youyc22/Multifunctional/hardware/hardware/PCB/主板/实物图.png

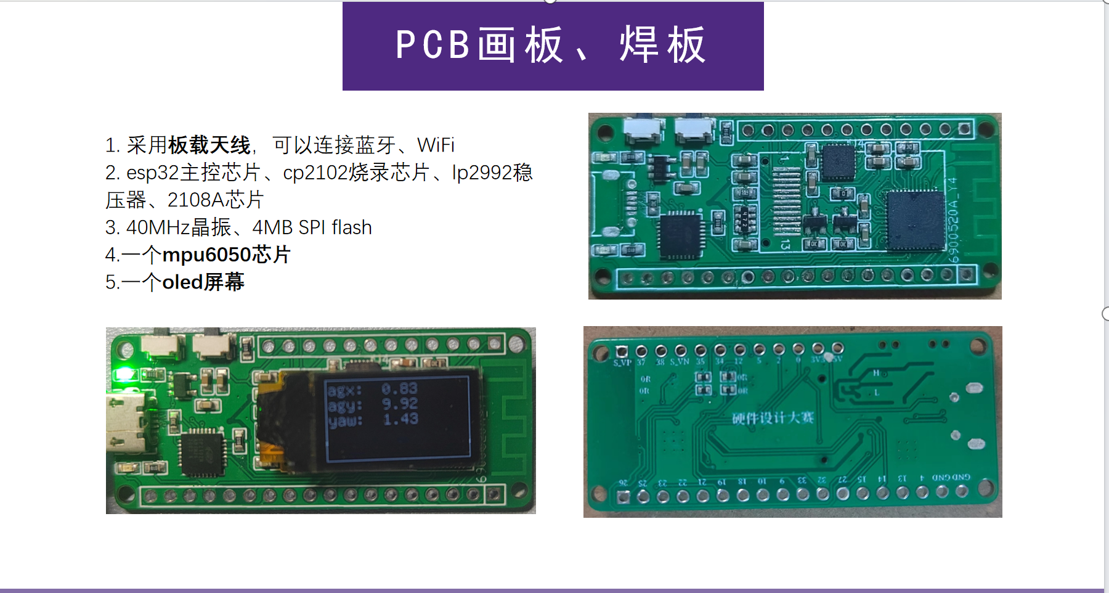
hardware/hardware/PCB/主板/实物图.png
