youyc22/Multifunctional/hardware/hardware/其他硬件材料/0a4875b89bd48880daa38f8a928440a.png

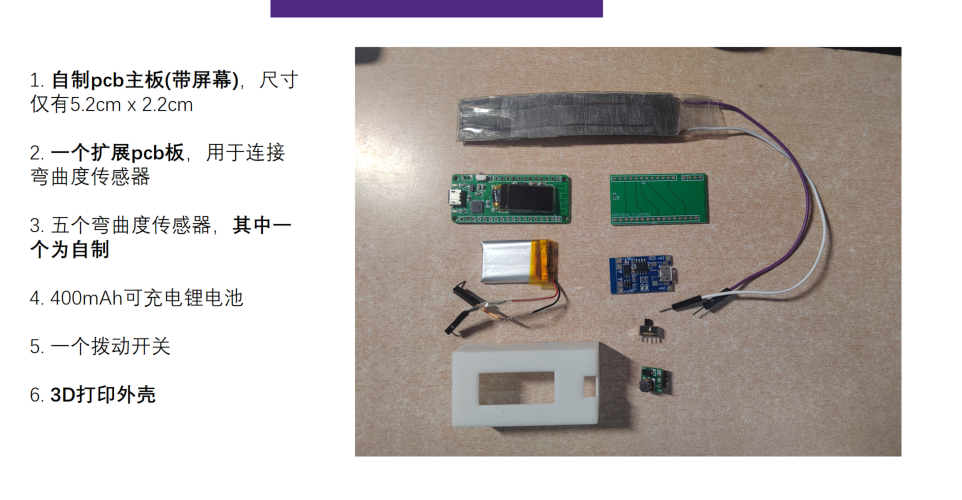
hardware/hardware/其他硬件材料/0a4875b89bd48880daa38f8a928440a.png
