youyc22/Multifunctional/hardware/Readme

1.PCB使用嘉立创eda
2.3D外壳可用solidworks打开
3.后续会较大改进PCB(画饼)
