youyc22/Multifunctional/software/Readme

1. Qt creator版本：5.11.3
2. unity3D：2022.3.3f1c1
3. arduino ide代码里的头文件都可在包管理器里下载
