youyc22/Multifunctional/完整报告.pdf

# 多功能蓝牙手套

无 23 尤忆晨 2022010576 无 21 李锦轩 2022010519

## 1.设计背景

我们组设计的作品名为多功能蓝牙手套，设计灵感来源于我们认为市面上的 PPT 翻页笔功能

太过单一，传统鼠标的使用太过局限，并且还存在一些不方便使用鼠标与键盘的场合，因此

我们组设计了一个数据手套来代替鼠标和键盘的功能。

## 2.功能简介

我们的多功能蓝牙手套主要有以下三个功能，首先是蓝牙键鼠，我们将手势分为默认手势以

及自定义手势，其中默认手势是我们已经设置好的，如食指弯曲相当于点击鼠标左键，中指

弯曲代表点击鼠标右键等等。第二个功能是手势自定义，我们用 Qt Creator 编写了一个上

位机能够让用户自定义手势（如图 1），手势可以是静态的，如比 OK 手势，也可以是动态的，

如打勾，用户在手势录制完成后可以在库中挑选对应的功能，如调整音量、局部截屏等等。

第三个功能是实时动捕，我们用 unity3D 搭建了一个手部模型（如图 2），能够捕捉到手部

的动作，并且搭建了简单的场景，能够完成拍球等简单交互。

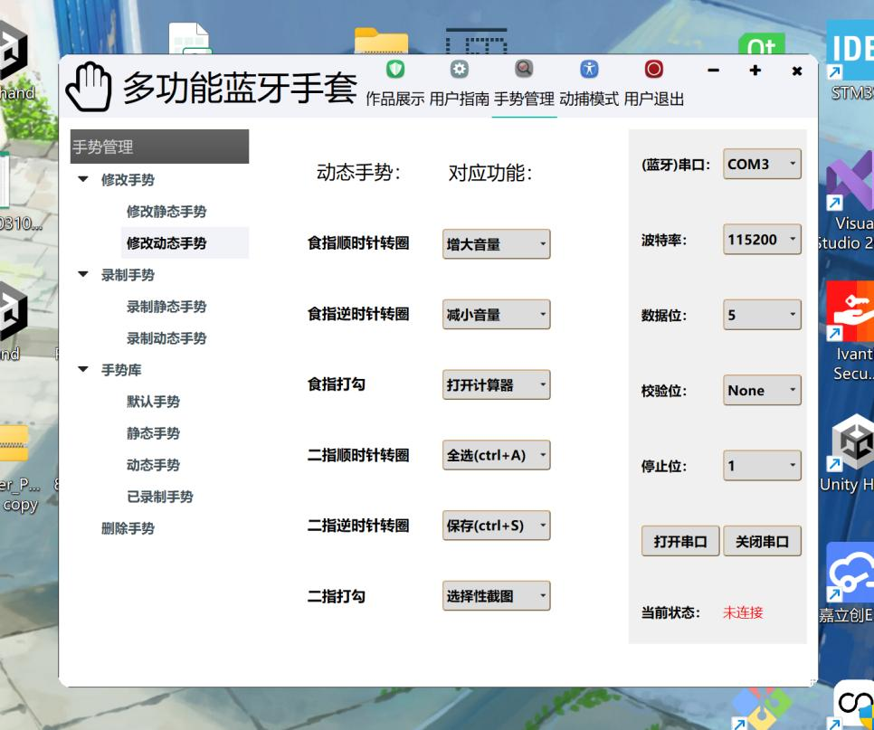
[picture p3: figure]

图 1

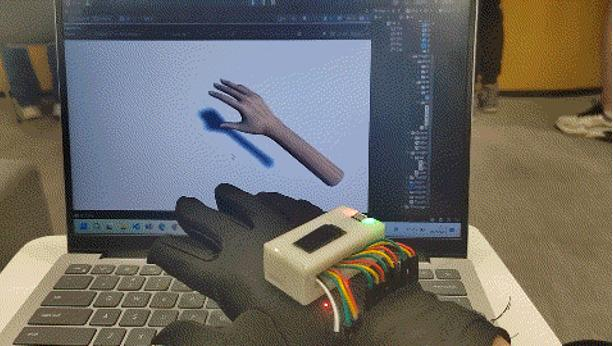
[picture p4: figure]

图 2

## 3.模块使用

为了使我们的手套更加轻便，我们使用了自制的 pcb 主板(带 oled 屏幕)，尺寸仅有 5.2cm x

2.2cm 和一个扩展 pcb 板，用于连接弯曲度传感器（如图 3-5）。在此期间我们一共打了三版

板子，但前两版均因集成度不够高被淘汰，最终第三版的体积能够满足我们的要求。我们的

pcb 板上搭载了一个 esp32 主控芯片、cp2102 烧录芯片、lp2992 稳压器、2108A 芯片和 40MHz

晶振、4MB SPI flash，以及一个 mpu6050 芯片和一个 oled 屏幕，并采用板载天线，可以连

接蓝牙、WiFi。我们在五根手指上装配了五个弯曲度传感器，其中一个为自制（如图 6）, 弯

曲度传感器实际上是一个高精度的薄片电阻，电阻弯曲后阻值发生变化。根据这个原理，我

们使用塑料片、白纸、铅笔芯、电线自制了一个简易的弯曲度传感器，基本可以满足手势识

别的需求。我们的手套还配有 400mAh 可充电锂电池，附带一个充电 usb 接口，充电完成后

可以大约续航三小时。此外手套上还装配了一个拨动开关和 3D 打印的外壳来放置板子。

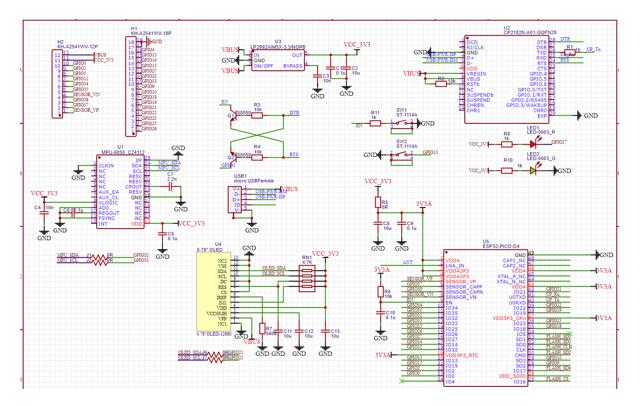
[picture p5: figure]

图 3

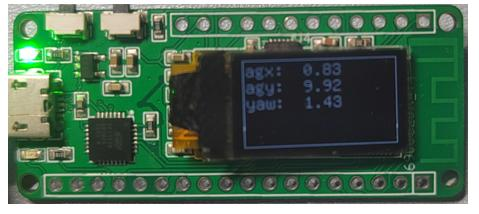
[picture p6: figure]

图 4

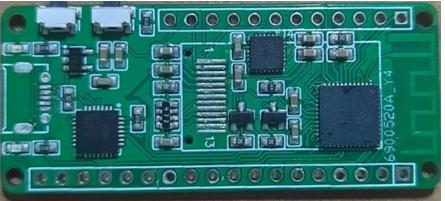
[picture p7: figure]

图 5

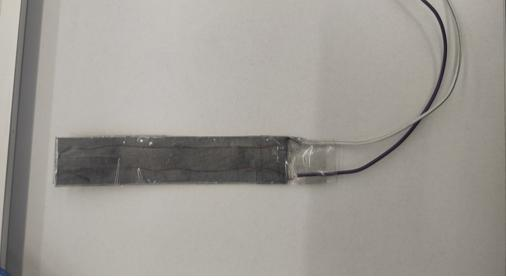
[picture p8: figure]

图 6

## 4.核心算法

（1）主程序框架

使用 3 层状态机

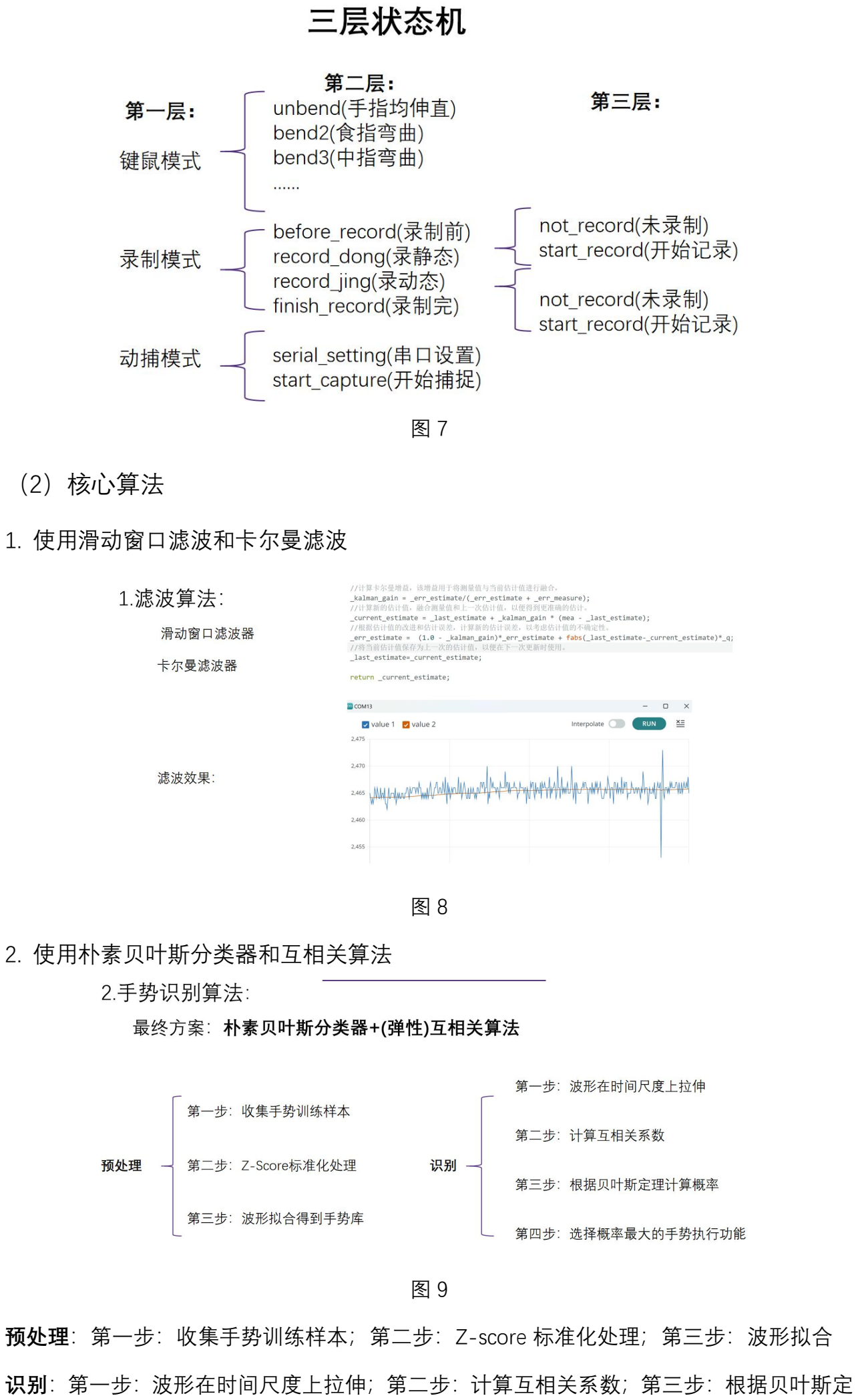
[picture p9: page 4]

图 7

## （2）核心算法

### 1. 使用滑动窗口滤波和卡尔曼滤波

图 8

### 2. 使用朴素贝叶斯分类器和互相关算法

图 9

### 预处理：第一步：收集手势训练样本；第二步：Z-score 标准化处理；第三步：波形拟合

### 识别：第一步：波形在时间尺度上拉伸；第二步：计算互相关系数；第三步：根据贝叶斯定

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

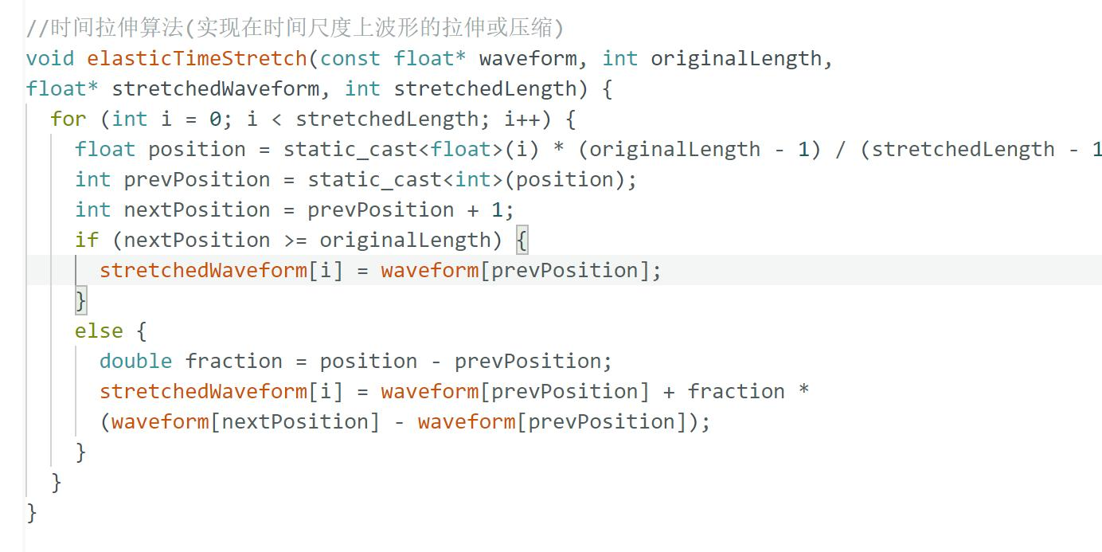
[picture p10: figure]
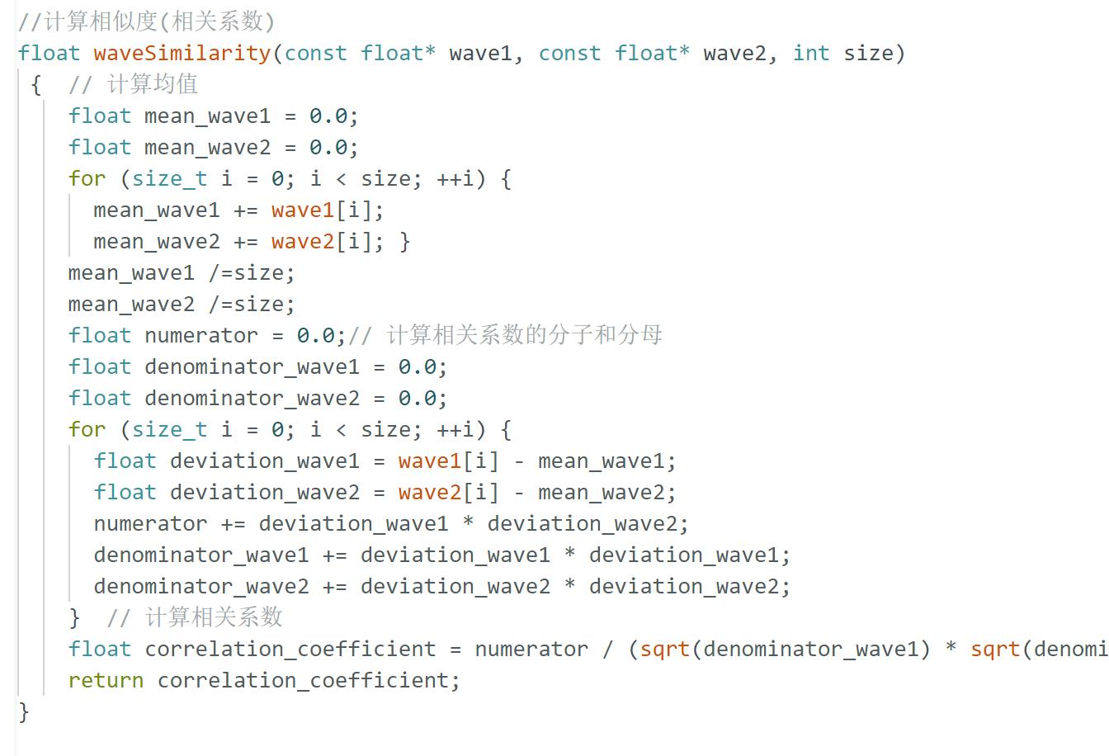
[picture p11: figure]

### 使用多线程执行程序，将蓝牙串口通信、oled 绘制等函数在新线程中执行，大大缩短

### 主程序执行时间，700 行主程序循环一次仅需 4 毫秒左右；

### 使用 SPIFFS 文件系统，实现上位机修改后的数据永久储存在开发板上，避免了反复烧

### 录的麻烦。

## 5.开发过程

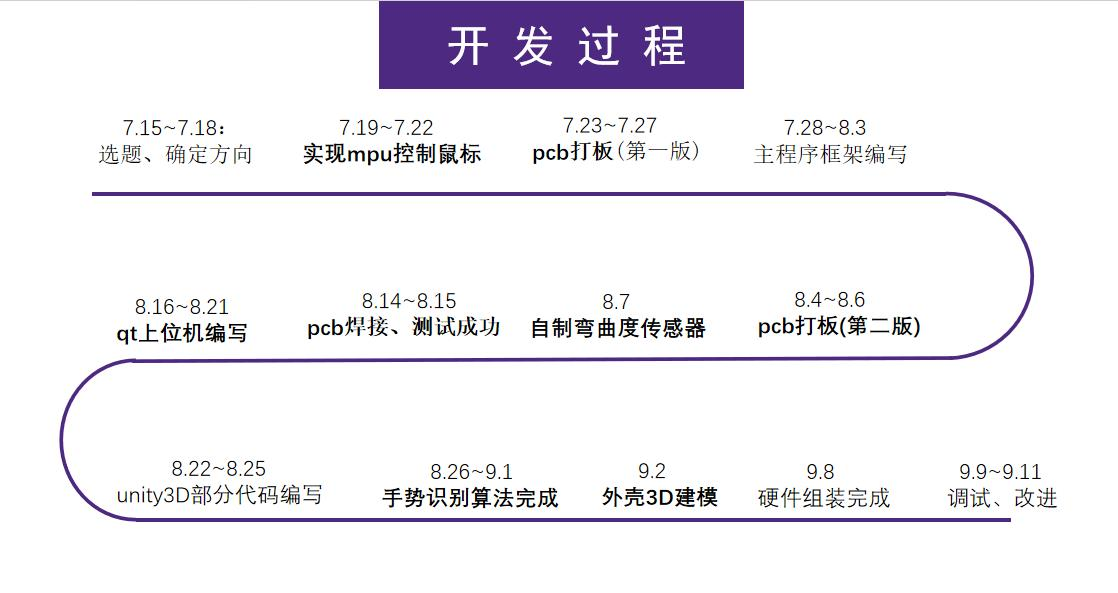
[picture p12: figure]

图 12
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
