youyc22/Multifunctional/hardware/hardware/PCB/扩展板/扩展版.jpg

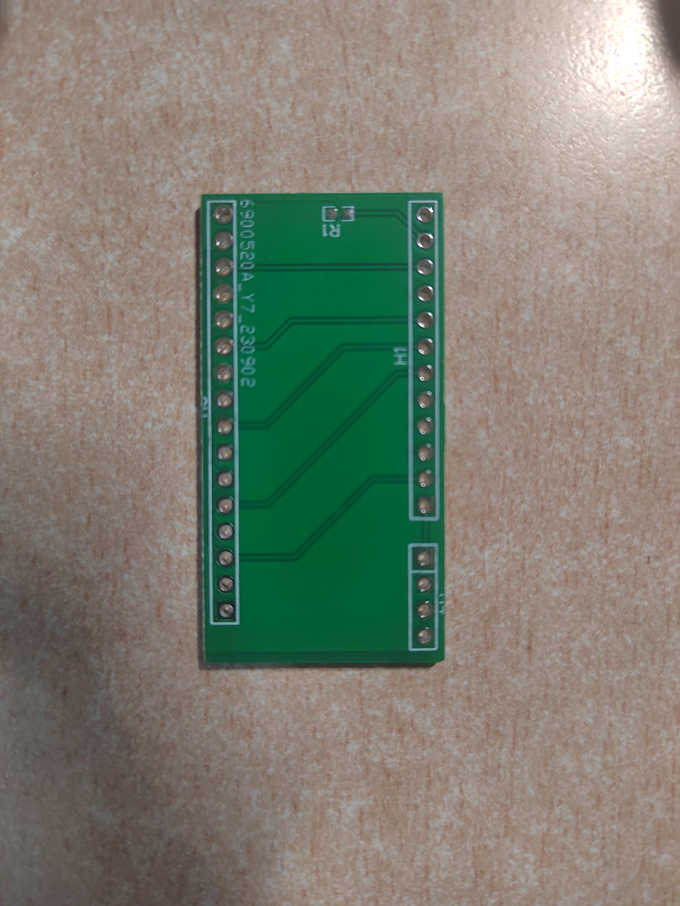
hardware/hardware/PCB/扩展板/扩展版.jpg
