youyc22/Multifunctional/hardware/hardware/PCB/扩展板/扩展版PCB.png

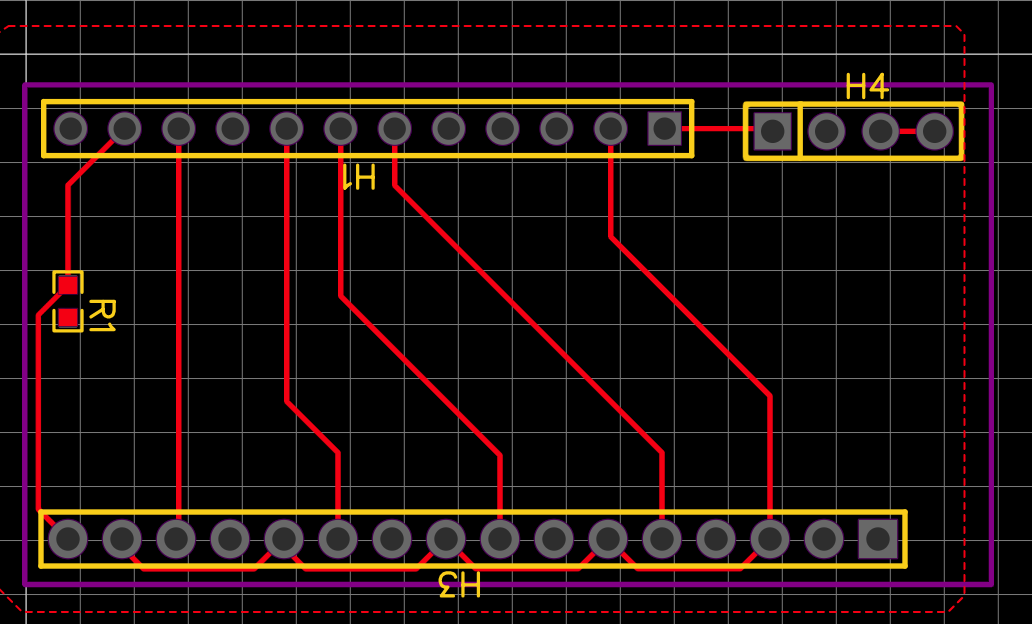
hardware/hardware/PCB/扩展板/扩展版PCB.png
