youyc22/Multifunctional/hardware/hardware/PCB/主板/PCB原理图.pdf

10 10 11 11 12 12 13 13 14 14 15 15 16 16 17 17 18 18

# GPIOs

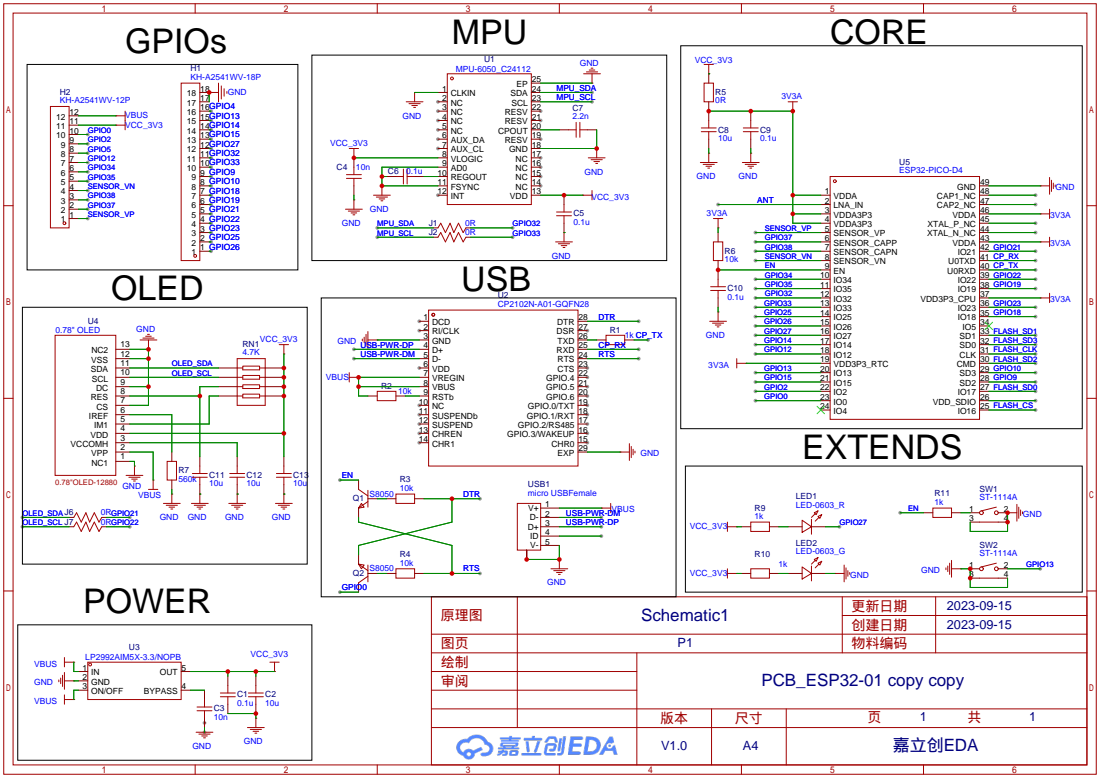
[picture p15: page 1]
