youyc22/Multifunctional/hardware/hardware/PCB/主板/PCB图.pdf

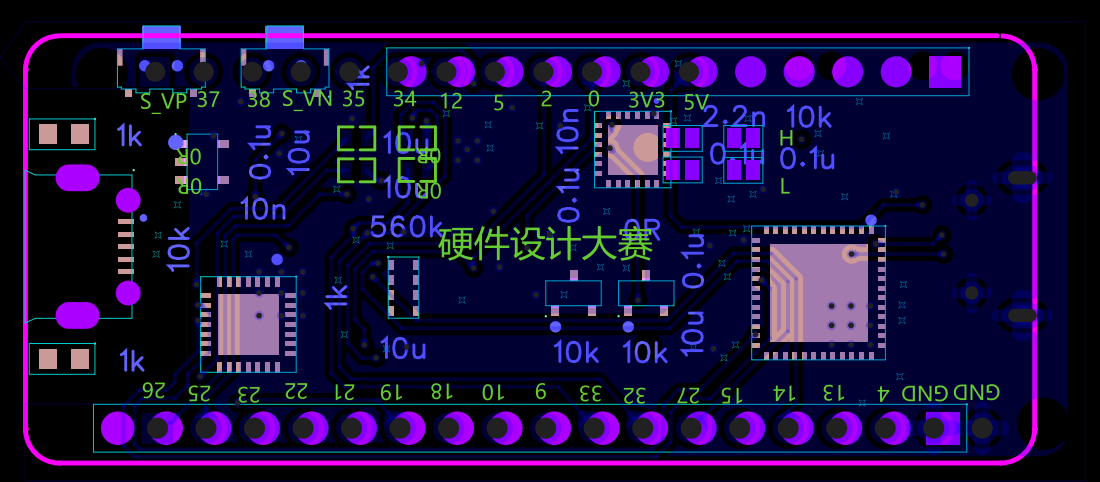
[picture p16: page 1]

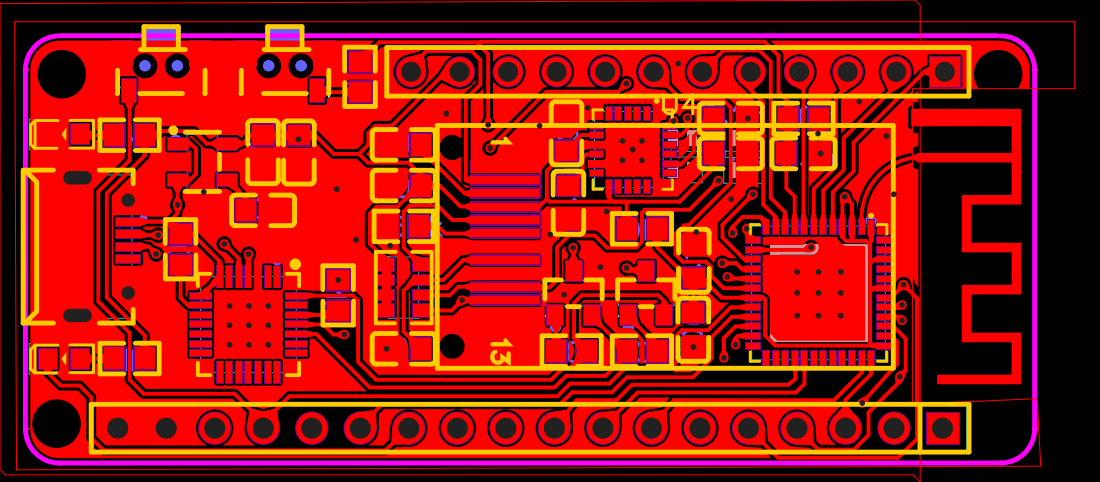
[picture p17: page 2]
