youyc22/Multifunctional/software/qt/uidemo01/main.cpp

#include "uidemo01.h"
#include "appinit.h"
#include <QApplication>
#include <QTextCodec>
#include <QFile>

int main(int argc, char *argv[])
{
    QApplication a(argc, argv);

#if (QT_VERSION <= QT_VERSION_CHECK(5,0,0))
#if _MSC_VER
    QTextCodec *codec = QTextCodec::codecForName("gbk");
#else
    QTextCodec *codec = QTextCodec::codecForName("utf-8");
#endif
    QTextCodec::setCodecForLocale(codec);
    QTextCodec::setCodecForCStrings(codec);
    QTextCodec::setCodecForTr(codec);
#else
    QTextCodec *codec = QTextCodec::codecForName("utf-8");
    QTextCodec::setCodecForLocale(codec);
#endif

    //加载样式表
    QFile file(":/qss/psblack.css");
    if (file.open(QFile::ReadOnly)) {
        QString qss = QLatin1String(file.readAll());
        QString paletteColor = qss.mid(20, 7);
        qApp->setPalette(QPalette(QColor(paletteColor)));
        qApp->setStyleSheet(qss);
        file.close();
    }

    a.setFont(QFont("Microsoft Yahei", 9));
    AppInit::Instance()->start();

    UIDemo01 w;
    w.resize(1200,1000);
    w.show();

    return a.exec();
}
